BaktiyarBr/ssc338Q/(commit log)

2026-09-25 minor changes
    [ssq338q_V1.kicad_pcb]
2026-09-28 traces done
    [bom.csv, designators.csv, positions.csv, ssq338q_V1.kicad_pcb, ssq338q_V1.kicad_sch]
2026-09-28 pcb finalized
    [ssq338q_V1.kicad_pcb]
2026-09-29 minor changes and prepared BOM
    [power.kicad_sch, ssq338q_V1.kicad_pcb, ssq338q_V1.kicad_sch]
2026-09-30 bom + alternative camera version copy
    [ssq338q_V1.kicad_sch]
2026-10-04 sd pullup, finilized design
    [bom.csv, designators.csv, positions.csv, ssq338q_V1.kicad_pcb, ssq338q_V1.kicad_sch]
